mltmyr/am_extruder_extra/docs/img/connections_side.pdf

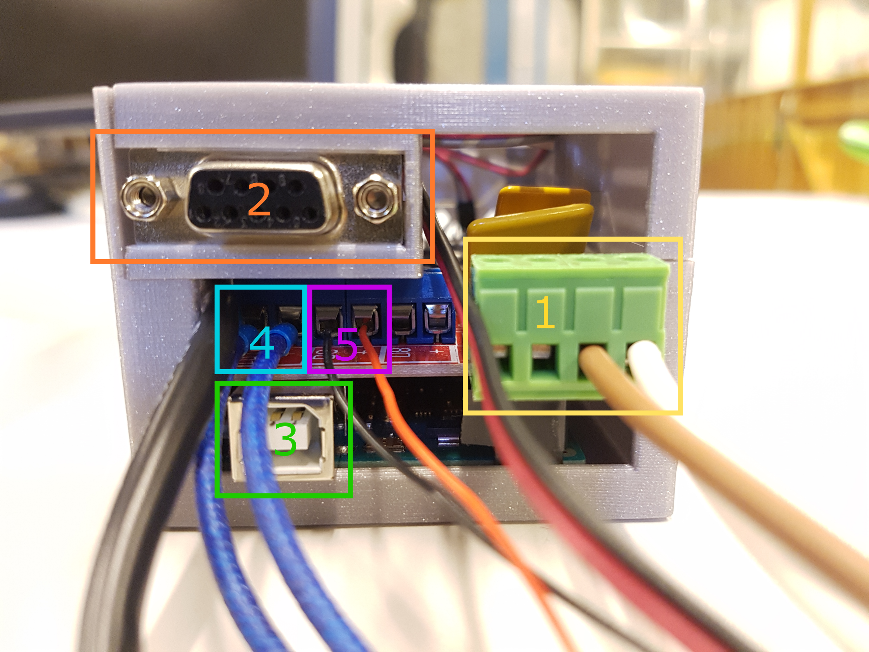
[picture p4: page 1]

2

1

3

4
5
