mltmyr/am_extruder_extra/cad/control_box_casing/arduino_ramps_box_top.stl

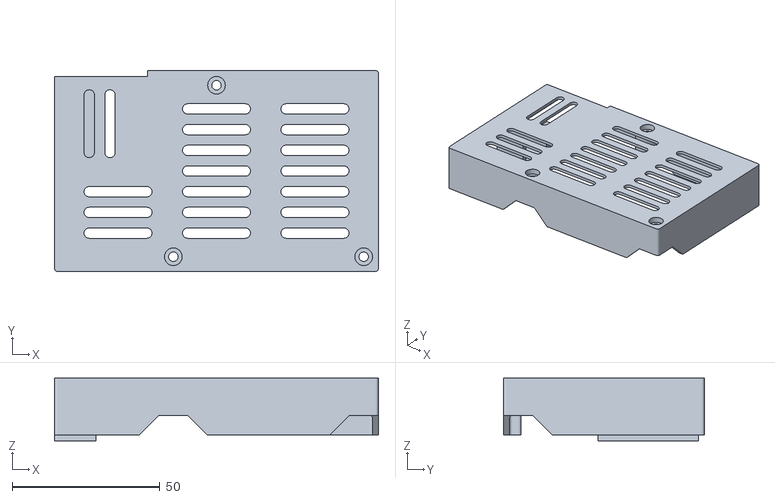
[picture p5: CAD file, 2021-11-01]
cad/control_box_casing/arduino_ramps_box_top.stl
109.6 x 68.0 x 21.2
