mltmyr/am_extruder_extra/cad/motor_bracket_v2/extruder_to_franka_mount_v2.stp

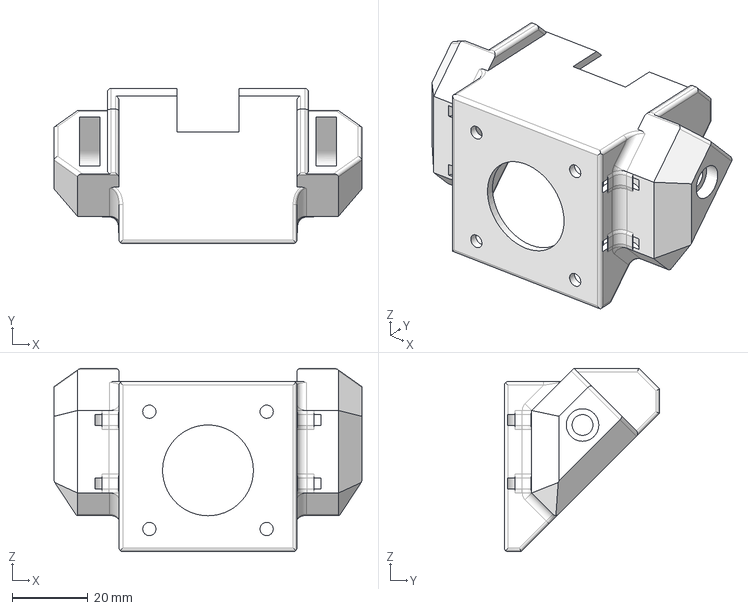
[picture p6: CAD file, 2021-11-01]
cad/motor_bracket_v2/extruder_to_franka_mount_v2.stp
81.4 x 41.0 x 48.5 mm
