mltmyr/am_extruder_extra/cad/control_box_casing/arduino_ramps_box_bottom.stl

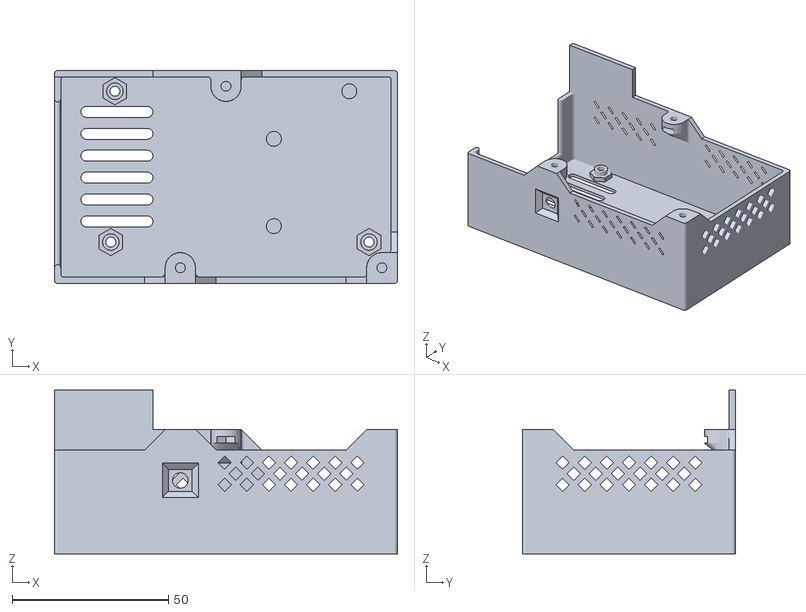
[picture p7: CAD file, 2021-11-01]
cad/control_box_casing/arduino_ramps_box_bottom.stl
109.6 x 68.0 x 52.4
