mltmyr/am_extruder_extra/cad/motor_bracket_v1/extruder_to_franka_bracket_v1.stp

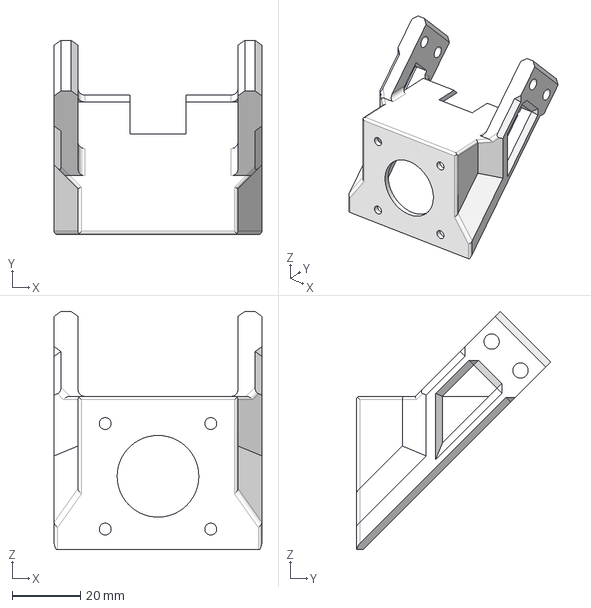
[picture p8: CAD file, 2021-11-01, an earlier design]
cad/motor_bracket_v1/extruder_to_franka_bracket_v1.stp
61.0 x 57.1 x 69.9 mm
