mltmyr/am_extruder_extra/(list of files, cad)

Other CAD files:
cad/control_box_casing/arduino_and_ramps_encasement.dwg
cad/motor_bracket_v1/extruder_to_franka_bracket_v1.dwg
cad/motor_bracket_v1/extruder_to_franka_bracket_v1.stl
cad/motor_bracket_v2/extruder_to_franka_mount_v2.dwg
cad/motor_bracket_v2/extruder_to_franka_mount_v2.stl
